Natchpai/LQRx-InterleavedBuck/documents/Images/GCM155R71H104KE02J-100nF50V.png

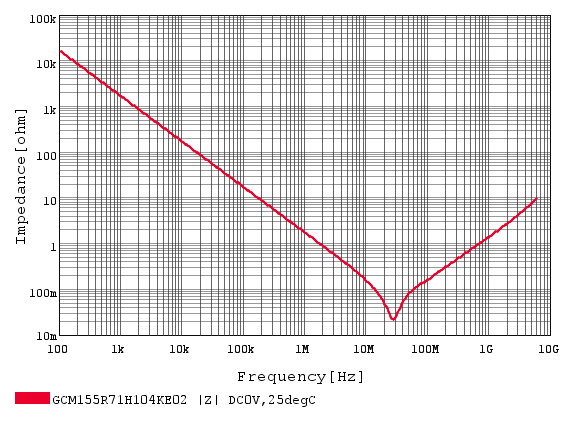
documents/Images/GCM155R71H104KE02J-100nF50V.png
