Natchpai/LQRx-InterleavedBuck/documents/Images/GRM21BZ71E106KE15L-10uF25V-Derating.png

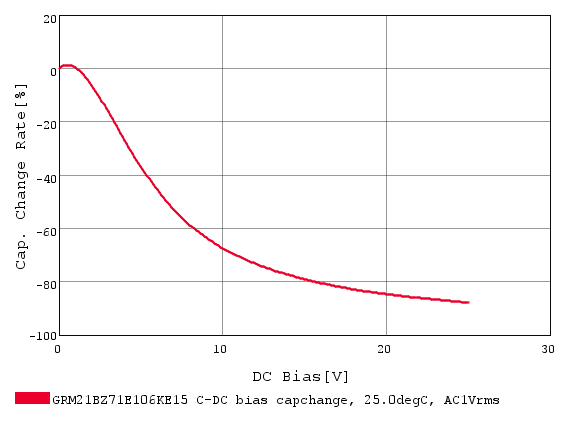
documents/Images/GRM21BZ71E106KE15L-10uF25V-Derating.png
