Natchpai/LQRx-InterleavedBuck/documents/Images/GRM21BZ71E475KE15L-4u7F25V-Derating.png

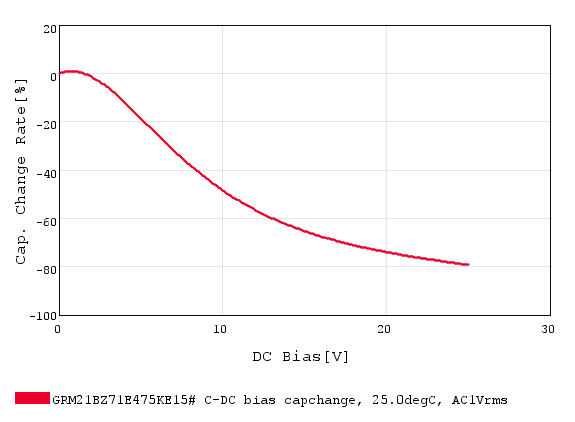
documents/Images/GRM21BZ71E475KE15L-4u7F25V-Derating.png
