Natchpai/LQRx-InterleavedBuck/documents/Images/GRM31CR71H475KA12L-4u7F50V_DC-Derate.png

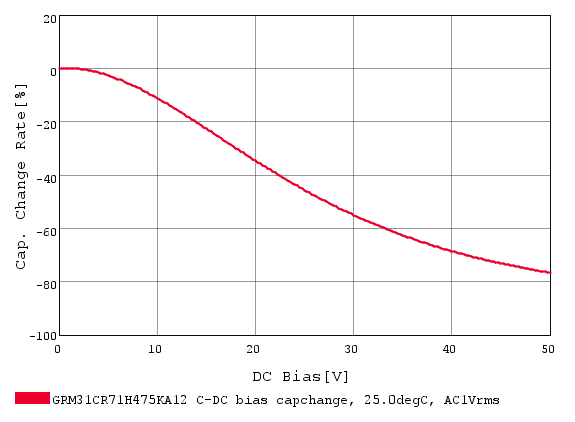
documents/Images/GRM31CR71H475KA12L-4u7F50V_DC-Derate.png
