Natchpai/LQRx-InterleavedBuck/documents/Images/GRM31CR71H475KA12L-4u7F50V_Z.png

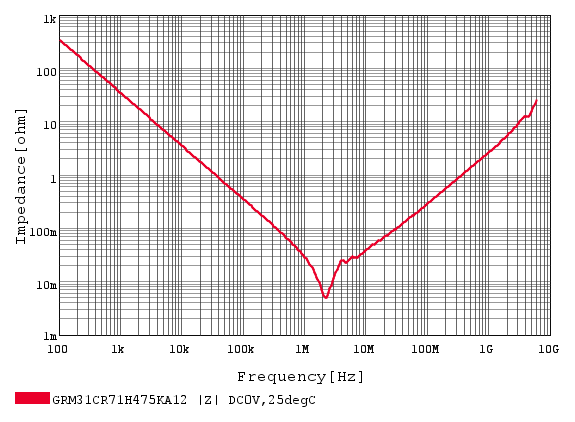
documents/Images/GRM31CR71H475KA12L-4u7F50V_Z.png
