Natchpai/LQRx-InterleavedBuck/documents/Images/GRM155R71E103KA01D.png

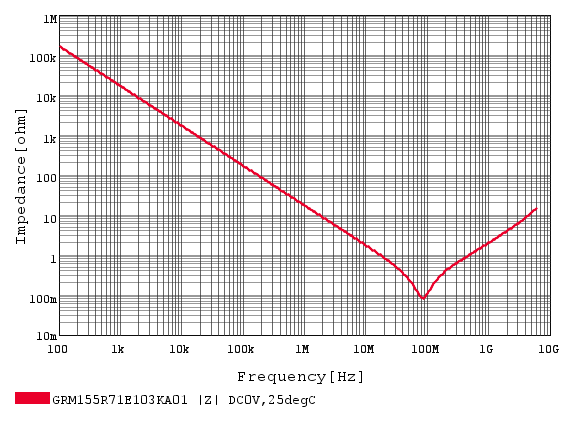
documents/Images/GRM155R71E103KA01D.png
