Natchpai/LQRx-InterleavedBuck/documents/Images/GRM1555C1E103JE01D.png

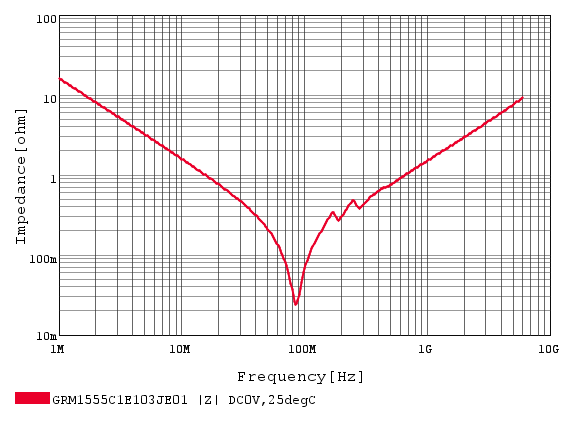
documents/Images/GRM1555C1E103JE01D.png
