Natchpai/LQRx-InterleavedBuck/documents/Images/GRT32ER71H475KE01L-4u7F50V_DC-Derate.png

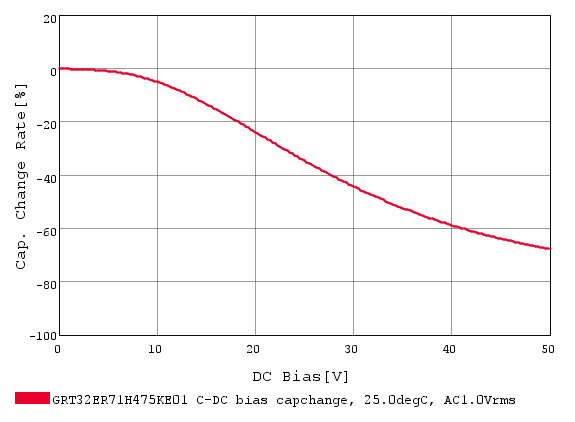
documents/Images/GRT32ER71H475KE01L-4u7F50V_DC-Derate.png
