Natchpai/LQRx-InterleavedBuck/documents/Images/Mini-Fit Jr 5569 4 Position Natural-nonBg.png

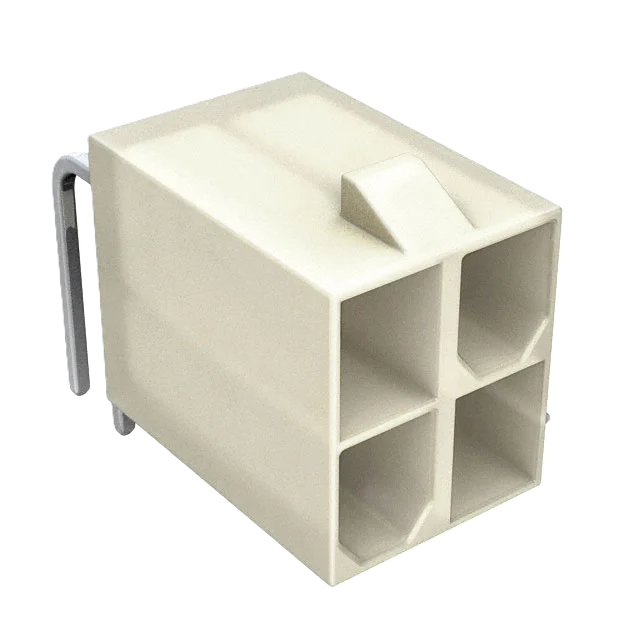
documents/Images/Mini-Fit Jr 5569 4 Position Natural-nonBg.png
