Natchpai/LQRx-InterleavedBuck/documents/Images/Render-Board/2Phase_SynchBuck_Bottomview_v1-1(Large).png

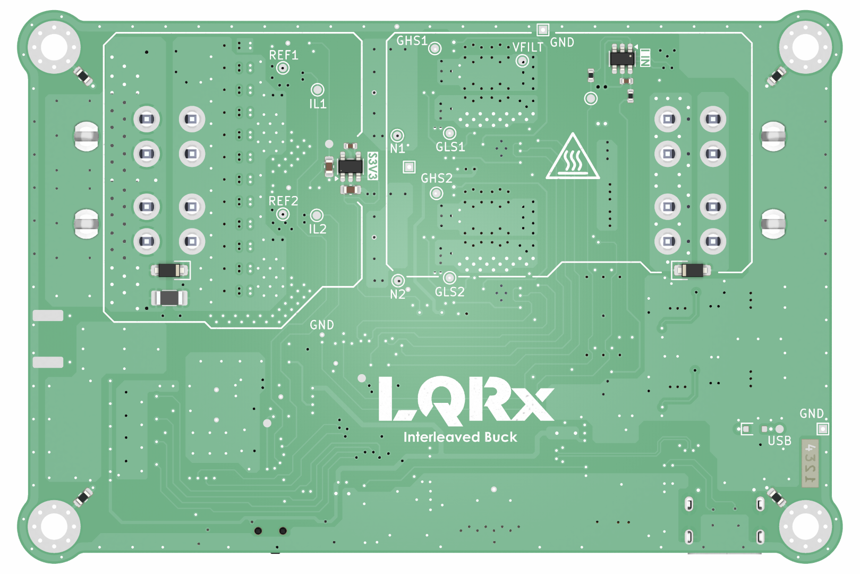
documents/Images/Render-Board/2Phase_SynchBuck_Bottomview_v1-1(Large).png
