Natchpai/LQRx-InterleavedBuck/documents/Images/Resistor_E96.png

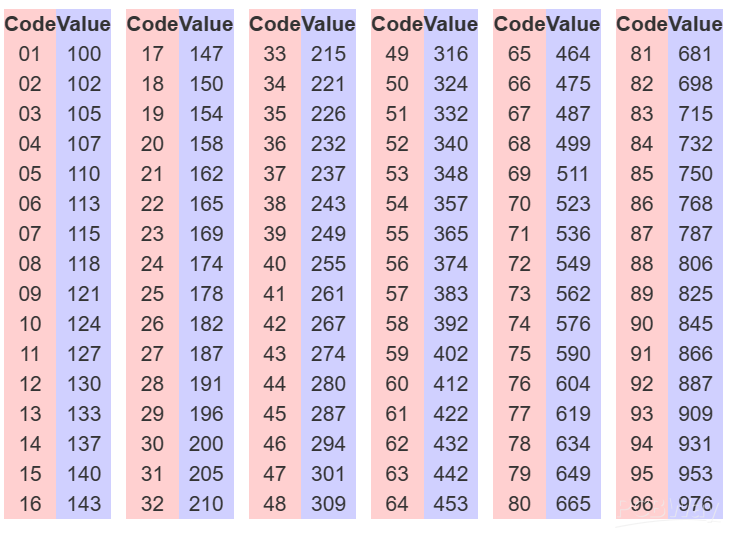
documents/Images/Resistor_E96.png
