Natchpai/LQRx-InterleavedBuck/documents/Manufacturing/Assembly/2Phase_SynchBuck-v1.1-24-08-2026__Assembly.pdf

C606 L102

# LD301 R107

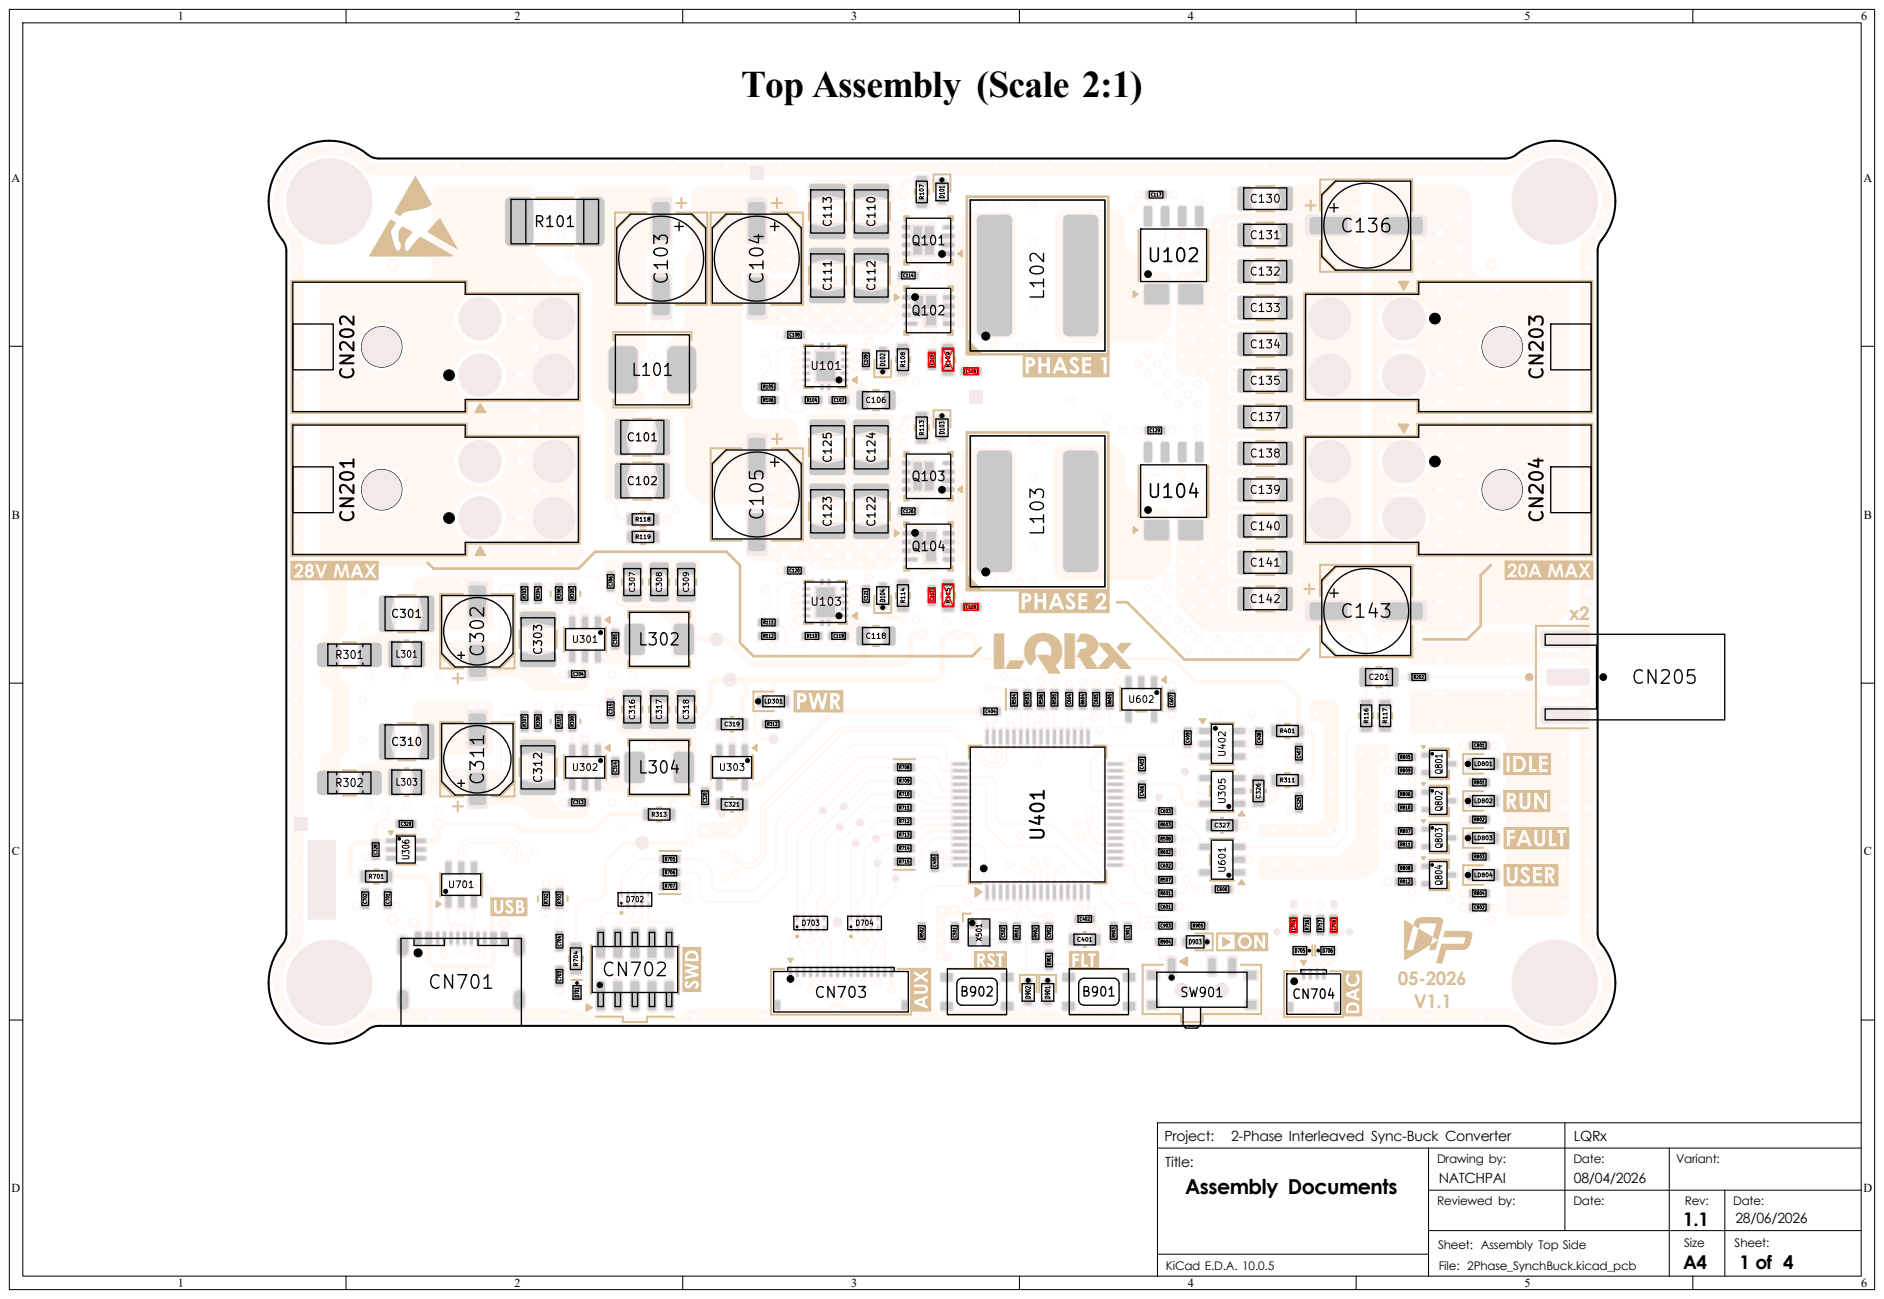
[picture p21: page 1]

Sheet: 2-Phase Interleaved Sync-Buck Converter

## GND VFILT

## GHS1

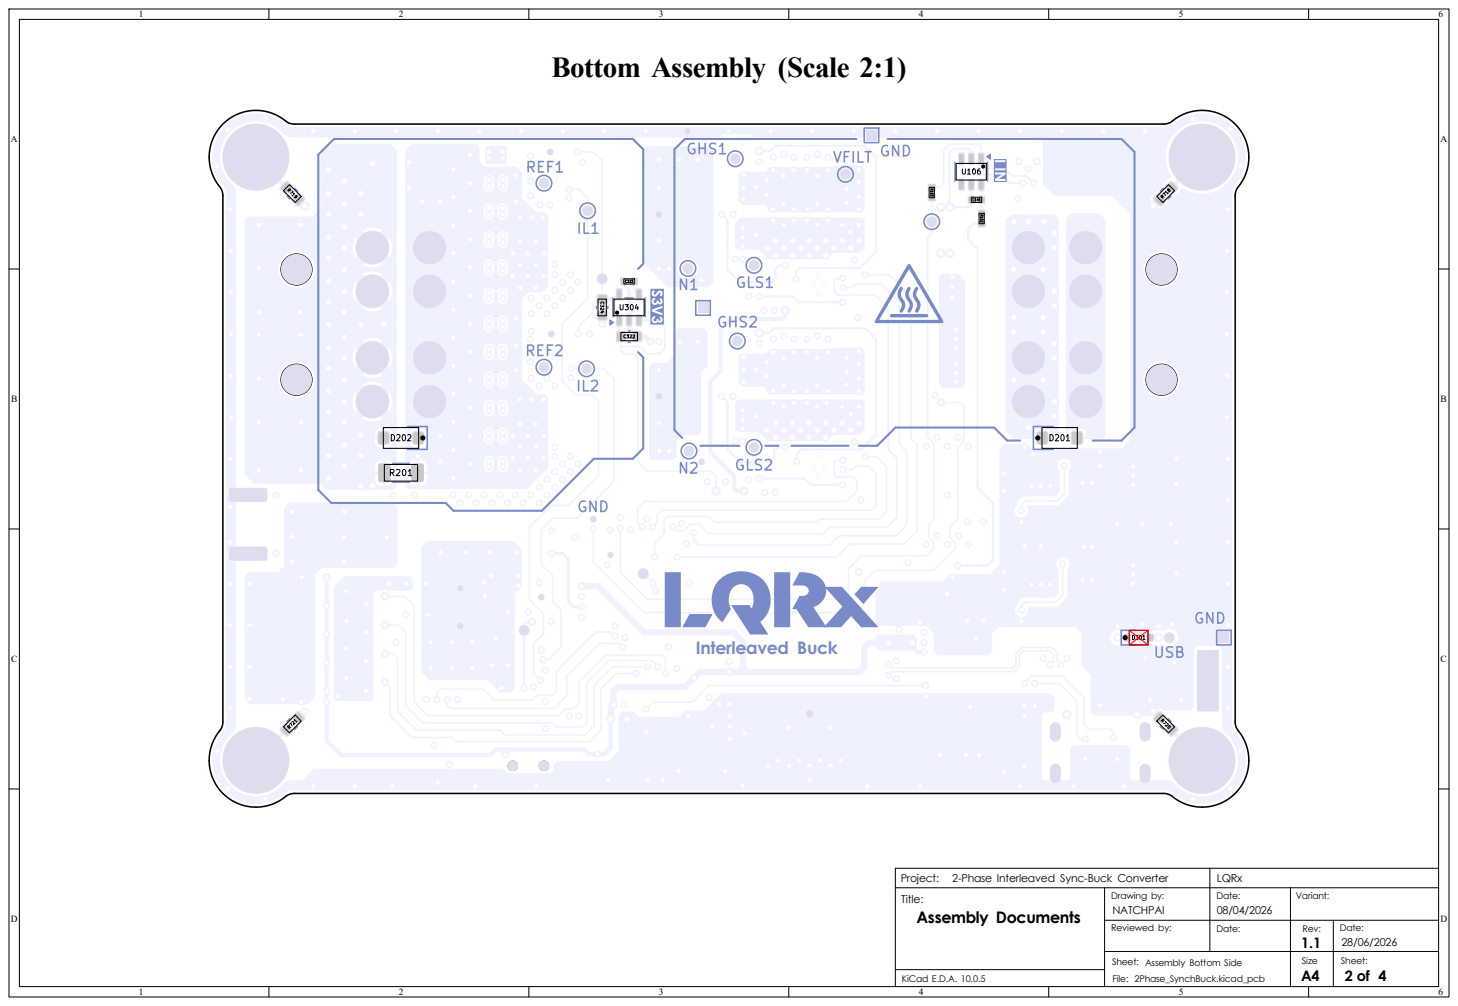
[picture p22: page 2]

Sheet: 2-Phase Interleaved Sync-Buck Converter

TP114

# DAC1 DAC2 Top Testpoint (Scale 2:1)

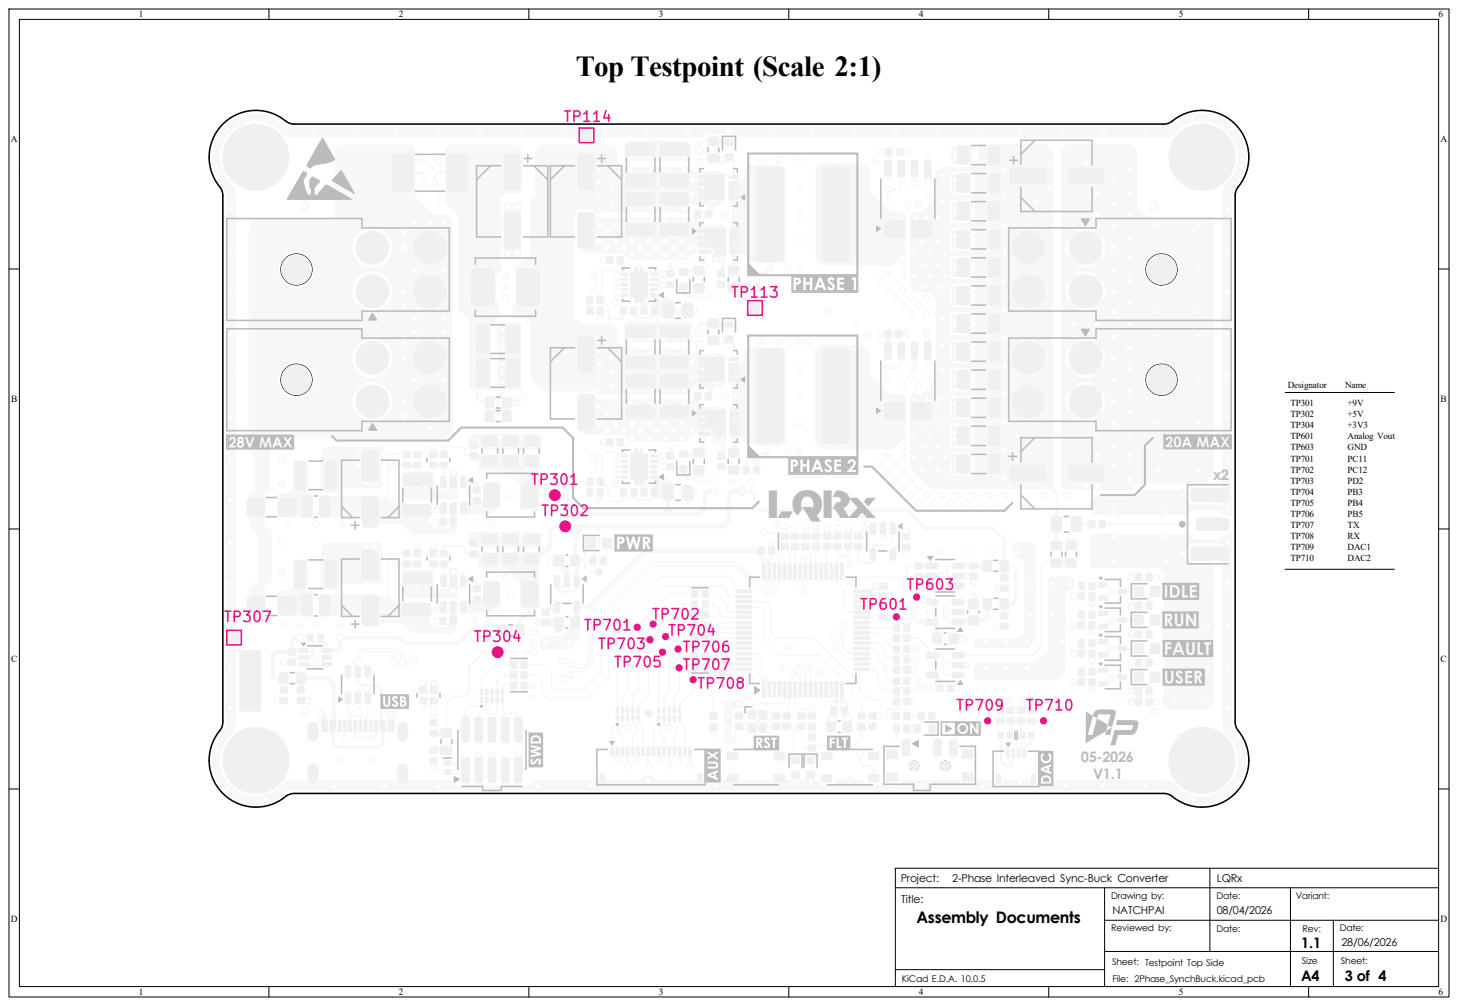
[picture p23: page 3]

Sheet: 2-Phase Interleaved Sync-Buck Converter

## GND VFILT

## GHS1

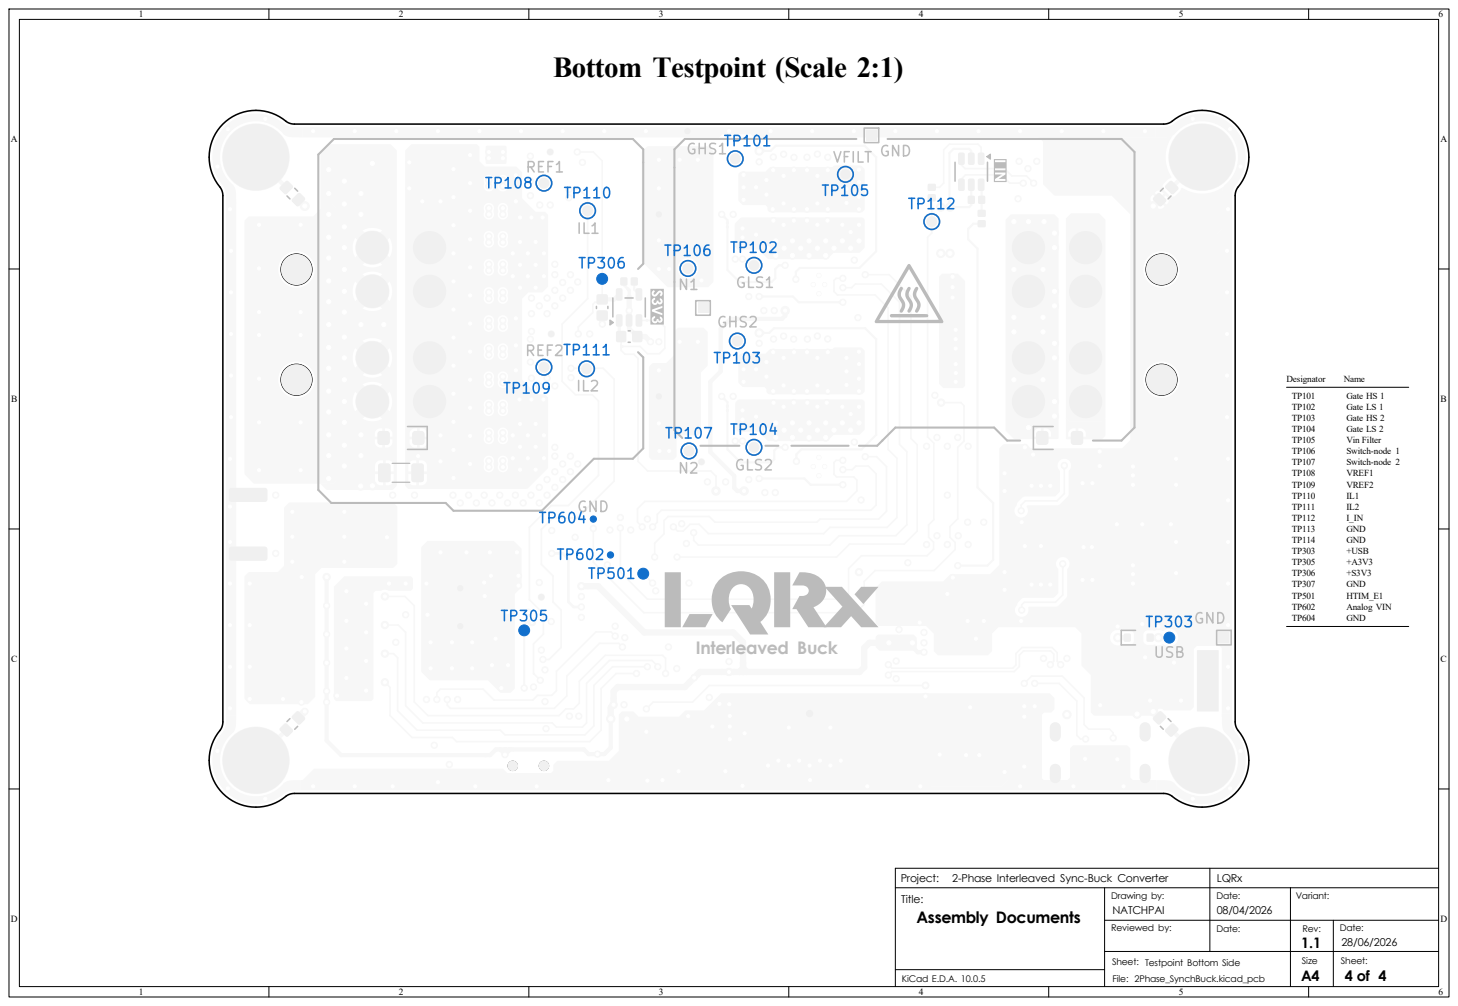
[picture p24: page 4]

Gate HS 1 Gate LS 1 Gate HS 2 Gate LS 2 Vin Filter Switch-node 1 Switch-node 2 VREF1 VREF2

Sheet: 2-Phase Interleaved Sync-Buck Converter
