Natchpai/LQRx-InterleavedBuck/documents/Manufacturing/Fabrication/2Phase_SynchBuck__FabricationDoc-v1.1.pdf

# Board Specifications

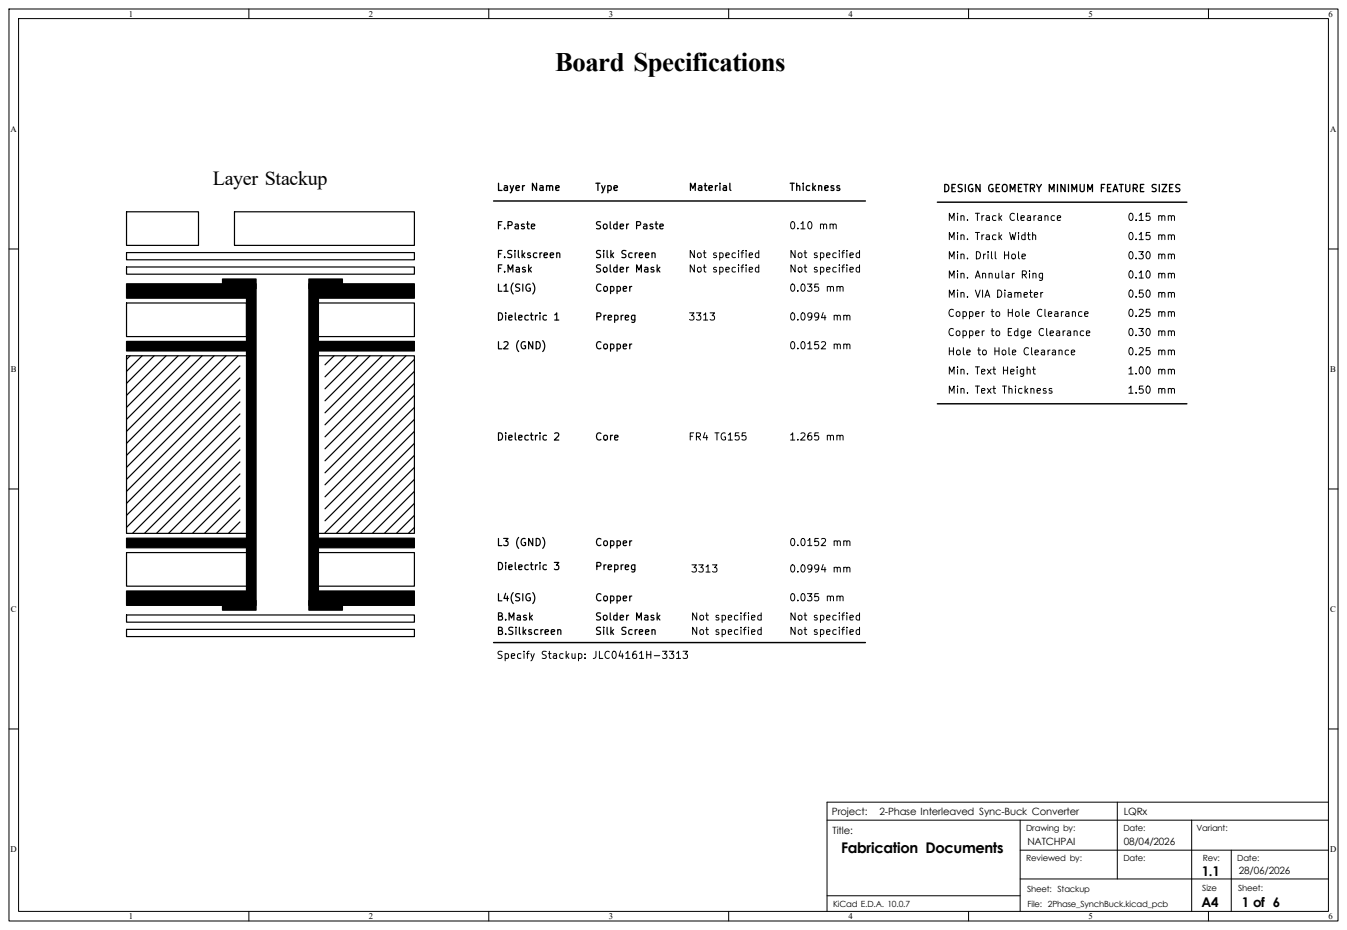
[picture p25: page 1]
Rev: 1.1; Stackup; Title:; Variant: Project:; Fabrication Documents; Size; Sheet: A4; LQRx Date: Date: KiCad E.D.A. 10.0.7; File: 2Phase_SynchBuck.kicad_pcb; Date: Specify Stackup: JLC04161H-3313; Not specified Not specified; F.Paste; F.Silkscreen F.Mask; L1(SIG); Dielectric 1; L2 (GND); Dielectric 2; L3 (GND); Dielectric 3; L4(SIG); B.Mask B.Silkscreen; Solder Paste; Silk Screen Solder Mask; Copper; Prepreg; Core; Solder Mask Silk Screen; Layer Name; Type; Material; Thickness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

Min. Track Clearance
Min. Track Width
Min. Drill Hole
Min. Annular Ring
Min. VIA Diameter
Copper to Hole Clearance
Copper to Edge Clearance
Hole to Hole Clearance
Min. Text Height
Min. Text Thickness

Sheet: 2-Phase Interleaved Sync-Buck Converter

Drawing by:
NATCHPAI Reviewed by:

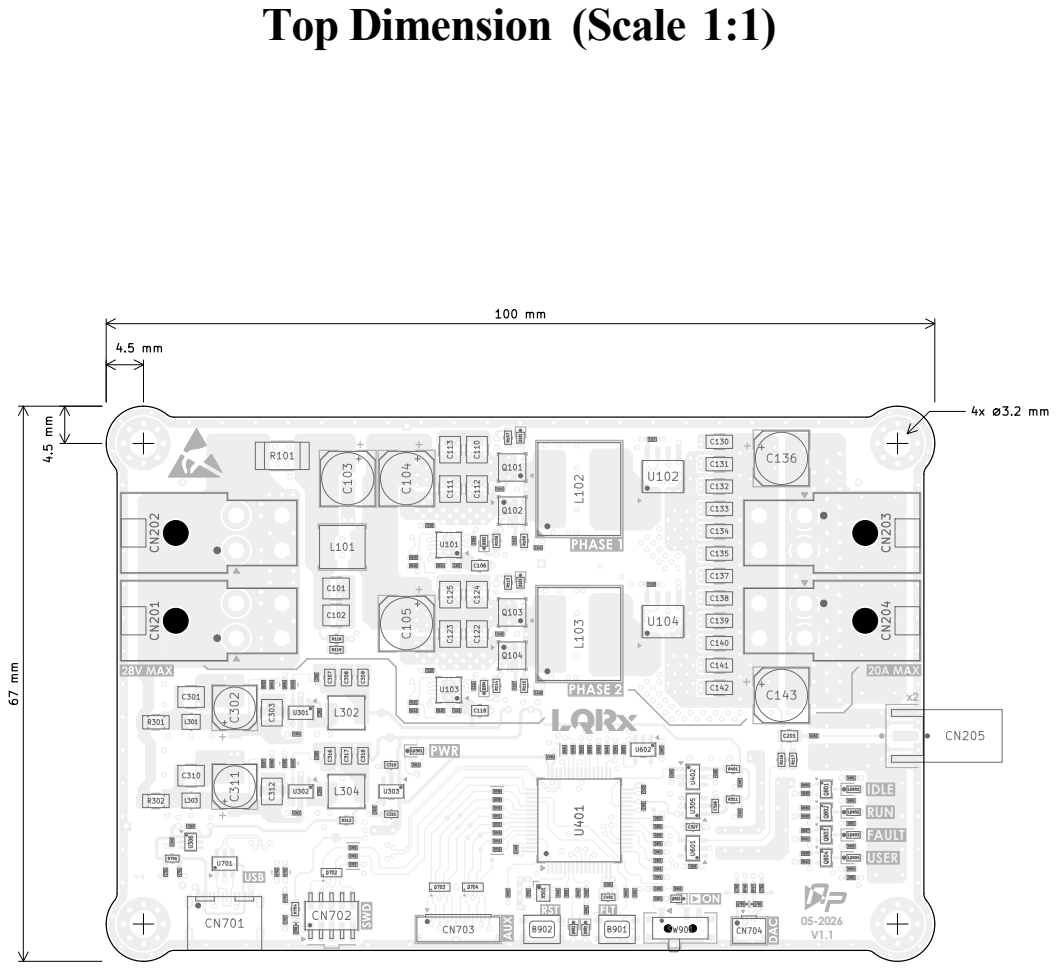
[picture p26: page 2]

Sheet: 2-Phase Interleaved Sync-Buck Converter

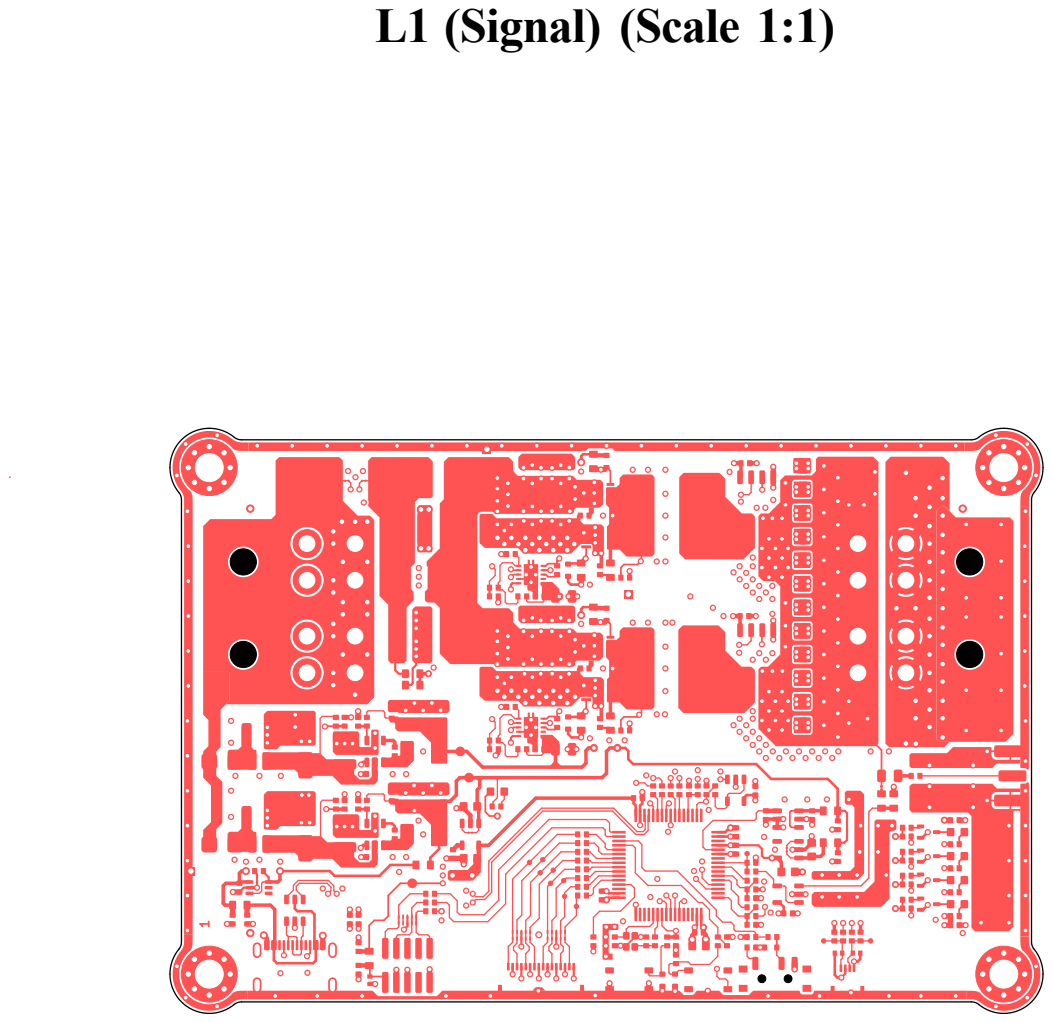
[picture p27: page 3]
Rev: 1.1; Fabri L1; Title:; Variant: Project:; Fabrication Documents; LQRx Date: Date: KiCad E.D.A. 10.0.7; File: 2Phase_SynchBuck.kicad_pcb; Date: L1 (Signal) (Scale 1:1)

Sheet: 2-Phase Interleaved Sync-Buck Converter

Drawing by:
NATCHPAI Reviewed by:

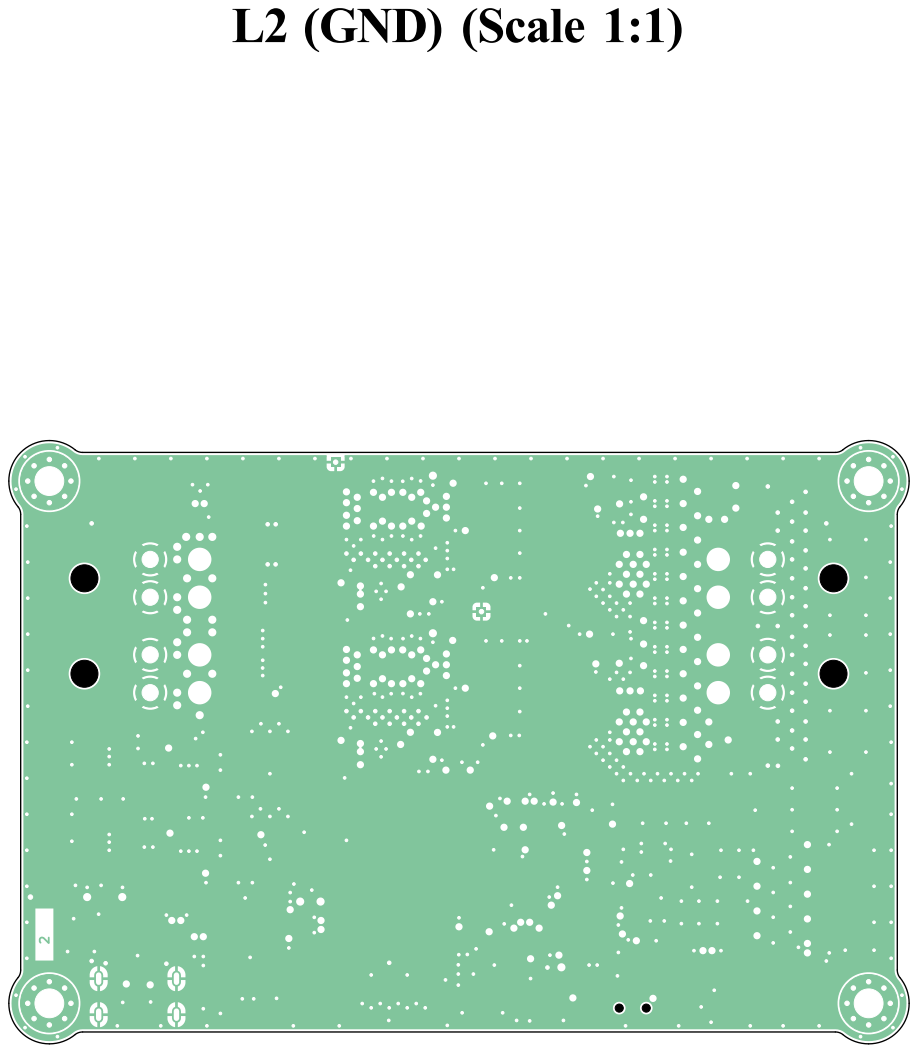
[picture p28: page 4]
Rev: 1.1; Title:; Variant: Project:; Fabrication Documents; LQRx Date: Date: KiCad E.D.A. 10.0.7; File: 2Phase_SynchBuck.kicad_pcb; Date: L2 (GND) (Scale 1:1)

Sheet: 2-Phase Interleaved Sync-Buck Converter

Drawing by:
NATCHPAI Reviewed by:

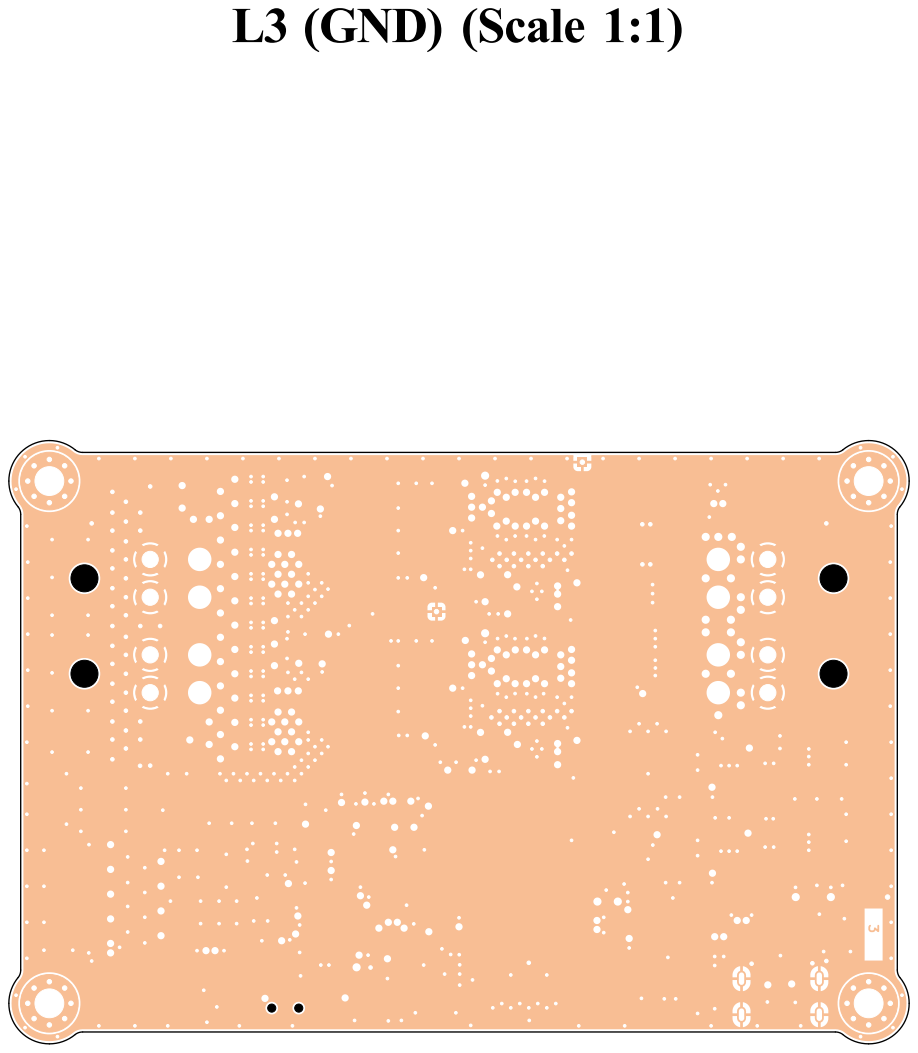
[picture p29: page 5]
Rev: 1.1; Title:; Variant: Project:; Fabrication Documents; LQRx Date: Date: KiCad E.D.A. 10.0.7; File: 2Phase_SynchBuck.kicad_pcb; Date: L3 (GND) (Scale 1:1)

Sheet: 2-Phase Interleaved Sync-Buck Converter

Drawing by:
NATCHPAI Reviewed by:

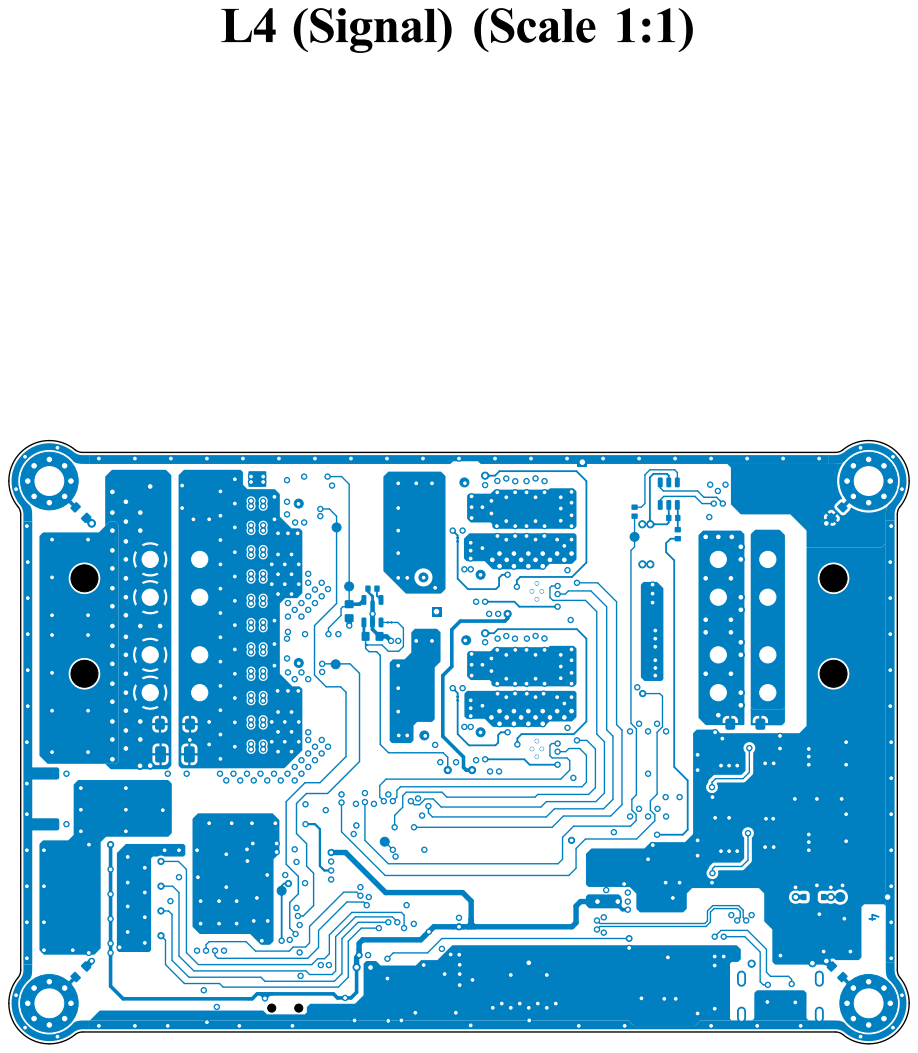
[picture p30: page 6]
Rev: 1.1; Title:; Variant: Project:; Fabrication Documents; LQRx Date: Date: KiCad E.D.A. 10.0.7; File: 2Phase_SynchBuck.kicad_pcb; Date: L4 (Signal) (Scale 1:1)

Sheet: 2-Phase Interleaved Sync-Buck Converter

Drawing by:
NATCHPAI Reviewed by:
