Natchpai/LQRx-InterleavedBuck/2Phase_SynchBuck.kicad_pcb

## KiCad design 2Phase_SynchBuck.kicad_pcb (2026-10-17)

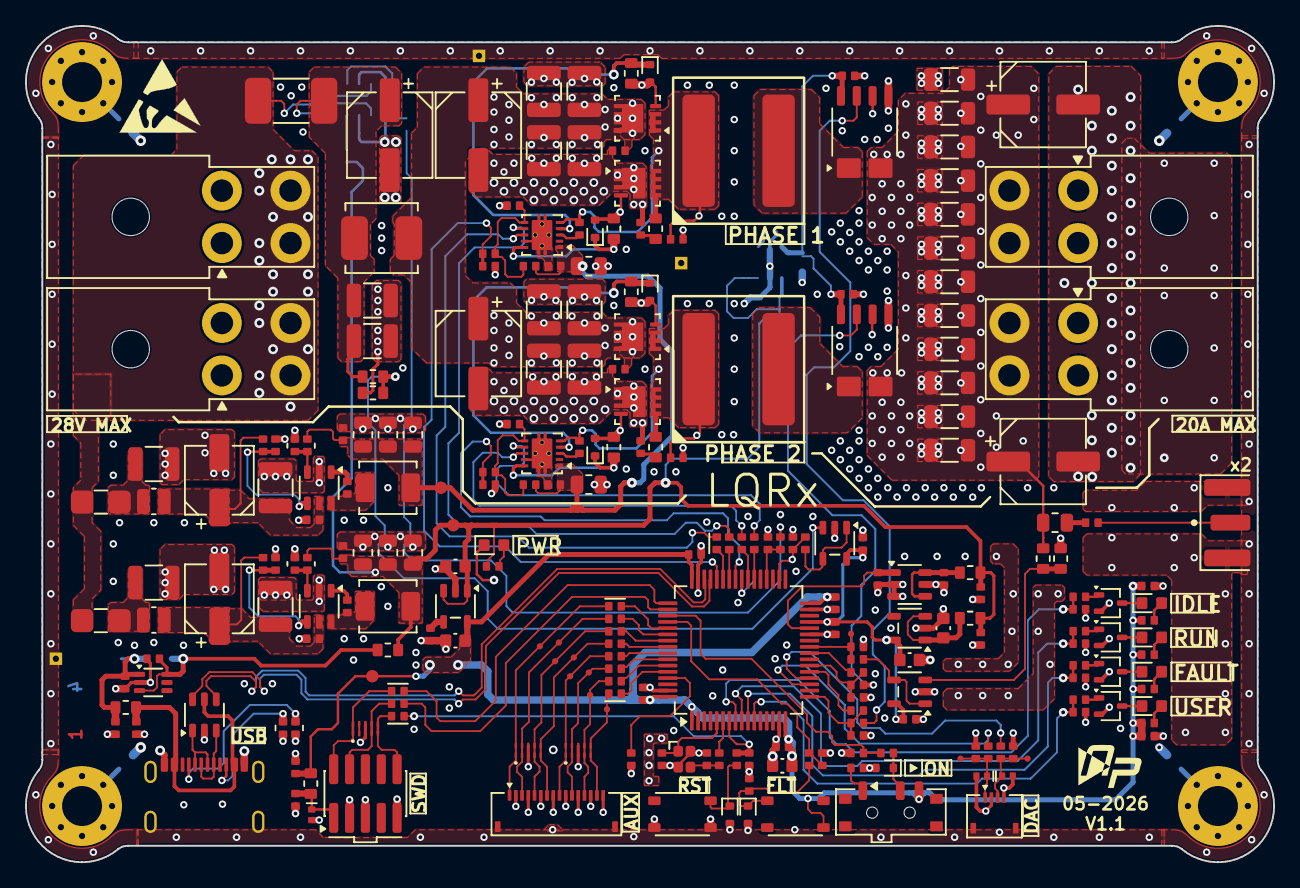
[picture p31: board 2Phase_SynchBuck.kicad_pcb from above]

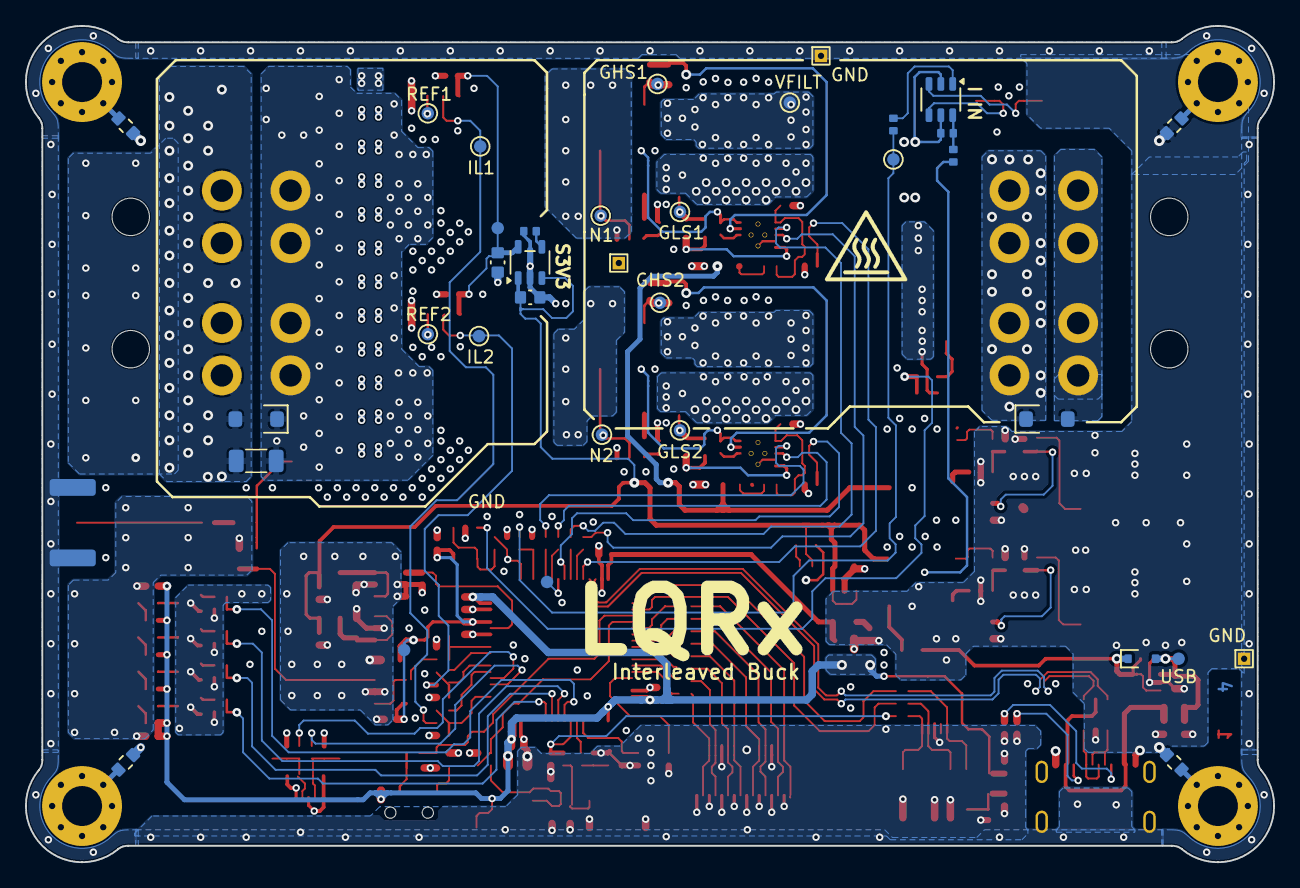
[picture p32: board 2Phase_SynchBuck.kicad_pcb from below]

Board: 4 copper layers, 100.0 x 67.0 mm, 305 parts (41 on the bottom side), 152 nets.

Parts:
B901, B902: SW_Tactile_PTS815SJM250
C101, C102, C110, C111, C112, C113, C122, C123, C124, C125, C301, C303, C310, C312: 4u7; C_1210_nomDensity
C103, C104, C105: 47u; CP_Elec_6.3x5.5_WCAP-ASLI
C106, C118, C307, C308, C309, C316, C317, C318: 4u7; C_0805_nomDensity
C107, C108, C109, C114, C117, C119, C120, C121, C126, C129, C145, C304, C305, C306, C313, C314, C315, C320, C323, C325, C328, C329, C402, C403, C404, C405, C406, C407, C408, C409, C606, C607, C701, C702, C703, C704, C705, C706, C801, C802, C901, C902, C903: 100n; C_0402_nomDensity
C115, C127: N/A; C_0402_nomDensity
C116, C128: 100p; C_0402_nomDensity
C130, C131, C132, C133, C134, C135, C137, C138, C139, C140, C141, C142: 4u7; C_1206_nomDesity
C136, C143: 47u; CP_Elec_6.3x6_OS-CON-SVPK
C201: 1u; C_0805_nomDensity
C302, C311: 22u; CP_Elec_5x5.5_WCAP-ASLI
C319, C321, C322, C324, C326, C327, C401: 2u2; C_0603_nomDensity
C501, C502: 6p8; C_0402_nomDensity
C601, C602, C603, C604, C605: 1n; C_0402_nomDensity
CN201, CN202, CN203, CN204: 04A2; Molex_Mini-Fit_Jr_5569-04A2_2x02_P4.20mm_Horizontal
CN205: SMA-J-P-H-ST-EM1; SMA_Samtec_SMA-J-P-H-ST-EM1_EdgeMount
CN701: USB4215-03-A; USB_C_Receptacle_GCT_USB4215-03-A_16P_TopMnt_Horizontal
CN702: Conn_JTAG_STDC10; BD_2x05_P1.27mm_Vertical_SMD
CN703: FFC2B28-16-G; GCT_FFC2B28-16_P0.5_FFC-16
CN704: FFC2B28-04-G; GCT_FFC2B28-04_P0.5_FFC-4
D101, D102, D103, D104: BAT54XV2T5G; D_SOD-523
D201, D202: SMF4L28A; D_SOD-123FL
D301: BAT60JFILM; D_SOD-323
D701, D705, D706: SP3031-01ETG; D_SOD-882
D702, D703, D704: PUSB3FR4Z; SOT1176-2-_1x2.5mm_P0.5mm
D901, D902, D903: ESD5Z3V3; D_SOD-523
G101: SYM_Hot_Large; hot_surface
G102: SYM_ESD_Large; ESD-Logo_6.6x6mm_SilkScreen
G103: np_logo_5mm
H701, H702, H703, H704: MountingHole_Pad; MountingHole_3.2mm_M3_Pad_Via
L101: 1u; AMPLH5030S
L102, L103: 10u; 744393665100
L301, L303: 2u2; L_0806_BDCD00201610
L302, L304: 22u; AMDLA4020S
LD301, LD802: Green; LED_0603_1608Metric
LD801, LD804: Orange; LED_0603_1608Metric
LD803: Red; LED_0603_1608Metric
NT101: IN_SENSE+; NetTie-2_SMD_Pad0.15mm
NT102: IN_SENSE-; NetTie-2_SMD_Pad0.15mm
NT103, NT104: sw node; NetTie-2_SMD_Pad0.2mm
NT105: Vsense; NetTie-2_SMD_Pad0.2mm
NT303, NT304, NT305: EN; NetTie-2_SMD_Pad0.15mm
Q101, Q103: BSZ018N04LS6; PG-TSDSON-8-26
Q102, Q104: IQE013N04LM6; PG-TSON-8-4
Q801, Q802, Q803, Q804: GS2N7002KW; SOT-323_SC-70
R101: 5m; R_PA2512_R005-R006_YAGEO
R102, R103, R501, R503, R504, R505, R506, R705, R706, R707, R708, R709, R710, R711, R712, R713, R714, R715, R716, R717: 22R; R_0402_nomDensity
R104, R110, R304, R306, R308, R310: 21k5; R_0402_nomDensity
R105, R111, R604, R805, R806, R807, R808, R902: 100R; R_0402_nomDensity
R106, R112, R809, R810, R811, R812: 100k; R_0402_nomDensity
R107, R108, R113, R114: 2R21; R_0603_nomDensity
R109, R115: N/A; R_0603_nomDensity
R116, R118: 90k9; R_0603_nomDensity
R117, R119: 10k; R_0603_nomDensity
R201: 1k; R_1206_YEGEO
R202, R507, R508, R601, R602, R603, R605: 49R9; R_0402_nomDensity
R301, R302: 20m; R_PA1206_R004-R020_YAGEO
R303: 162k; R_0402_nomDensity
R305: 221k; R_0402_nomDensity
R307: 110k; R_0402_nomDensity
R309: 118k; R_0402_nomDensity
R311, R313, R401, R701, R704, R718, R719, R720, R721: 0R; R_0603_nomDensity
R312, R702, R703: 5k11; R_0402_nomDensity
R502, R802, R803, R903, R905: 1k; R_0402_nomDensity
R801, R804: 499; R_0402_nomDensity
R901, R904: 10k; R_0402_nomDensity
SW901: SW_SPDT; SW_SPDT_PCM12
TP101: Gate HS 1; TestPoint_Pad_D1.0mm_Bottom
TP102: Gate LS 1; TestPoint_Pad_D1.0mm_Bottom
TP103: Gate HS 2; TestPoint_Pad_D1.0mm_Bottom
TP104: Gate LS 2; TestPoint_Pad_D1.0mm_Bottom
TP105: Vin Filter; TestPoint_Pad_D1.0mm_Bottom
TP106: Switch-node 1; TestPoint_Pad_D1.0mm_Bottom
TP107: Switch-node 2; TestPoint_Pad_D1.0mm_Bottom
TP108: VREF1; TestPoint_Pad_D1.0mm_Bottom
TP109: VREF2; TestPoint_Pad_D1.0mm_Bottom
TP110: IL1; TestPoint_Pad_D1.0mm_Bottom
TP111: IL2; TestPoint_Pad_D1.0mm_Bottom
TP112: I_IN; TestPoint_Pad_D1.0mm_Bottom
TP113, TP114, TP307: GND; TestPoint_THTPad_1.0x1.0mm_Drill0.5mm
TP301: +9V; TestPoint_NoSlik_D1.0mm_Top
TP302: +5V; TestPoint_NoSlik_D1.0mm_Top
TP303: +USB; TestPoint_NoSlik_D1.0mm_Bottom
TP304: +3V3; TestPoint_NoSlik_D1.0mm_Top
TP305: +A3V3; TestPoint_NoSlik_D1.0mm_Bottom
TP306: +S3V3; TestPoint_NoSlik_D1.0mm_Bottom
TP501: HTIM_E1; TestPoint_NoSlik_D1.0mm_Bottom
TP601: Analog Vout; TestPoint_NoSlik_D0.5mm_Top
TP602: Analog VIN; TestPoint_NoSlik_D0.5mm_Bottom
TP603: GND; TestPoint_NoSlik_D0.5mm_Top
TP604: GND; TestPoint_NoSlik_D0.5mm_Bottom
TP701: PC11; TestPoint_NoSlik_D0.5mm_Top
TP702: PC12; TestPoint_NoSlik_D0.5mm_Top
TP703: PD2; TestPoint_NoSlik_D0.5mm_Top
TP704: PB3; TestPoint_NoSlik_D0.5mm_Top
TP705: PB4; TestPoint_NoSlik_D0.5mm_Top
TP706: PB5; TestPoint_NoSlik_D0.5mm_Top
TP707: TX; TestPoint_NoSlik_D0.5mm_Top
TP708: RX; TestPoint_NoSlik_D0.5mm_Top
TP709: DAC1; TestPoint_NoSlik_D0.5mm_Top
TP710: DAC2; TestPoint_NoSlik_D0.5mm_Top
U101, U103: UCC27282DRC; 10-VSON(3x3)-DRC
U102, U104: ACS37030LLZATR-040B3; ACS37030LLZA
U106: INA187A1IDBVR; SOT-23-6
U301, U302: LMR54410DBVR; SOT-23-6
U303, U304: SPX3819M5-L-3-3/TR; SOT-23-5
U305: LDLN025M33R; SOT-23-5
U306: LM66100DCK; DCK0006A_TI
U401: STM32G474RET6; LQFP-64_10x10mm_P0.5mm
U402: MCP1501T-30E; SOT-23-6
U601, U602: TLV9061SIDBVR; SOT-23-5
U701: USBLC6-2SC6; SOT-23-6
X501: ABM11W-24MHz-8; ABM11W_2.0x1.6mm

Connections:
+3V3: B901.1, B901.2, C321.1, C401.1, C402.1, C403.1, C404.1, C405.1, C704.1, C801.1, C802.1, R704.2, R801.1, R802.1, R803.1, R804.1, SW901.3 (C), TP304.1 (1_1), U303.5 (OUT), U401.1 (VBAT), U401.16 (VDD), U401.32 (VDD), U401.48 (VDD), U401.64 (VDD)
+5V: C315.1, C316.1, C317.1, C318.1, C319.1, C322.1, C325.1, C407.1, L304.2, NT303.1, NT304.1, R102.1, R309.1, R311.1, R312.1, R313.2, R401.1, TP302.1 (1_1), U303.1 (IN), U304.1 (IN)
+9V: C106.1, C107.1, C118.1, C119.1, C306.1, C307.1, C308.1, C309.1, L302.2, R104.2, R110.1, R305.1, TP301.1 (1_1), U101.1 (VDD), U103.1 (VDD)
+A3V3: C327.1, C406.1, C606.1, C607.2, TP305.1 (1_1), U305.5 (OUT), U401.29 (VDDA), U601.5 (V+), U602.5 (V+)
+S3V3: C117.1, C129.1, C324.1, TP306.1 (1_1), U102.6 (VDD), U104.6 (VDD), U304.5 (OUT)
+VIN: C101.1, C102.1, C103.1, L101.1, NT102.2, R101.2, R118.1
+VUSB: C328.1, C702.1, D301.2 (A), R701.2, TP303.1 (1_1), U306.1 (VIN)
/Top/Analog Front-End/OP_FB_VIN: R605.1, U602.1, U602.4 (-)
/Top/Analog Front-End/OP_FB_VO: R603.1, U601.1, U601.4 (-)
/Top/Interface Interconnects/AUX1_TR1: CN703.1, D703.1 (K), D703.10, R708.1, TP701.1 (1_1)
/Top/Interface Interconnects/AUX1_TR2: CN703.3, D703.2 (K), D703.9, R709.1, TP702.1 (1_1)
/Top/Interface Interconnects/AUX1_TR3: CN703.5, D703.4 (K), D703.7, R710.1, TP703.1 (1_1)
/Top/Interface Interconnects/AUX1_TR4: CN703.7, D703.5 (K), D703.6, R711.1, TP704.1 (1_1)
/Top/Interface Interconnects/AUX1_TR5: CN703.9, D704.1 (K), D704.10, R712.1, TP705.1 (1_1)
/Top/Interface Interconnects/AUX1_TR6: CN703.11, D704.2 (K), D704.9, R713.1, TP706.1 (1_1)
/Top/Interface Interconnects/CC1: CN701.A5 (CC1), R703.1
/Top/Interface Interconnects/CC2: CN701.B5 (CC2), R702.1
/Top/Interface Interconnects/DAC1_TR: C705.1, CN704.1, D705.1, R716.1, TP709.1 (1_1)
/Top/Interface Interconnects/DAC2_TR: C706.1, CN704.3, D706.1, R717.1, TP710.1 (1_1)
/Top/Interface Interconnects/MT1: H701.1 (1_1), R718.1
/Top/Interface Interconnects/MT2: H702.1 (1_1), R719.1
/Top/Interface Interconnects/MT3: H703.1 (1_1), R720.1
/Top/Interface Interconnects/MT4: H704.1 (1_1), R721.1
/Top/Interface Interconnects/NRST_TR: CN702.10 (NRESET), D702.5 (K), D702.6, R707.1
/Top/Interface Interconnects/RX_TR: CN703.15, D704.5 (K), D704.6, R715.1, TP708.1 (1_1)
/Top/Interface Interconnects/SWCLK_TR: CN702.4 (SWDCLK/TCK), D702.4 (K), D702.7, R706.1
/Top/Interface Interconnects/SWDIO_TR: CN702.2 (SWDIO/TMS), D702.1 (K), D702.10, R705.1
/Top/Interface Interconnects/TX_TR: CN703.13, D704.4 (K), D704.7, R714.1, TP707.1 (1_1)
/Top/Interface Interconnects/USB_IN+: CN701.A6 (D+), CN701.B6 (D+), U701.3 (I/O2)
/Top/Interface Interconnects/USB_IN-: CN701.A7 (D-), CN701.B7 (D-), U701.1 (I/O1)
/Top/Interface Interconnects/VTREF: C703.1, CN702.1 (VTRef), D701.1, R704.1
/Top/Interface Interconnects/VUSB_IN: C701.1, CN701.A4 (VBUS), CN701.A9 (VBUS), CN701.B4 (VBUS), CN701.B9 (VBUS), R701.1, U701.5 (VBUS)
/Top/MCU IOs/ADC1_I_CH1: C601.1, R507.1, R601.2, U401.17 (PA3)
/Top/MCU IOs/ADC2_I_CH2: C602.1, R508.1, R602.2, U401.22 (PC4)
/Top/MCU IOs/ADC3_VOUT: C603.1, R603.2, TP601.1 (1_1), U401.25 (PB1)
/Top/MCU IOs/ADC4_I_IN: C604.1, R604.2, U401.36 (PB14)
/Top/MCU IOs/ADC4_VIN: C605.1, R605.2, TP602.1 (1_1), U401.34 (PB12)
/Top/MCU IOs/BOOT0: R502.1, U401.61 (PB8)
/Top/MCU IOs/BT1_USER: C901.1, R903.2, U401.52 (PC10)
/Top/MCU IOs/COMP2_I_CH1: R507.2, U401.21 (PA7)
/Top/MCU IOs/COMP4_I_CH2: R508.2, U401.24 (PB0)
/Top/MCU IOs/DAC1_OUT2: R716.2, U401.19 (PA5)
/Top/MCU IOs/DAC2_OUT1: R717.2, U401.20 (PA6)
/Top/MCU IOs/EN_CH1: R105.1, R106.1, U401.44 (PA10)
/Top/MCU IOs/EN_CH2: R111.1, R112.1, U401.41 (PC9)
/Top/MCU IOs/HRTIM_CHE1: TP501.1 (1_1), U401.40 (PC8)
/Top/MCU IOs/LED_FAULT: R807.1, R811.1, U401.10 (PC2)
/Top/MCU IOs/LED_IDLE: R805.1, R809.1, U401.8 (PC0)
/Top/MCU IOs/LED_RUN: R806.1, R810.1, U401.9 (PC1)
/Top/MCU IOs/LED_USER1: R808.1, R812.1, U401.11 (PC3)
/Top/MCU IOs/NRST: C902.1, R707.2, R902.1, U401.7 (PG10)
/Top/MCU IOs/OSC_IN: C501.1, U401.5 (PF0), X501.1
/Top/MCU IOs/OSC_OUT: R501.1, U401.6 (PF1)
/Top/MCU IOs/PB3: R711.2, U401.56 (PB3)
/Top/MCU IOs/PB4: R712.2, U401.57 (PB4)
/Top/MCU IOs/PB5: R713.2, U401.58 (PB5)
/Top/MCU IOs/PC11: R708.2, U401.53 (PC11)
/Top/MCU IOs/PC12: R709.2, U401.54 (PC12)
/Top/MCU IOs/PD2: R710.2, U401.55 (PD2)
/Top/MCU IOs/PWM_HS_1_TR: R503.2, U401.42 (PA8)
/Top/MCU IOs/PWM_HS_2_TR: R505.2, U401.38 (PC6)
/Top/MCU IOs/PWM_HS_CH1: R503.1, U101.7 (HI)
/Top/MCU IOs/PWM_HS_CH2: R505.1, U103.7 (HI)
/Top/MCU IOs/PWM_LS_1_TR: R504.2, U401.43 (PA9)
/Top/MCU IOs/PWM_LS_2_TR: R506.2, U401.39 (PC7)
/Top/MCU IOs/PWM_LS_CH1: R504.1, U101.8 (LI)
/Top/MCU IOs/PWM_LS_CH2: R506.1, U103.8 (LI)
/Top/MCU IOs/SW1_USER: C903.1, R905.2, U401.51 (PA15)
/Top/MCU IOs/SWCLK: R706.2, U401.50 (PA14)
/Top/MCU IOs/SWDIO: R705.2, U401.49 (PA13)
/Top/MCU IOs/USART1_RX: R715.2, U401.60 (PB7)
/Top/MCU IOs/USART1_TX: R714.2, U401.59 (PB6)
/Top/MCU IOs/USB_D+: U401.46 (PA12), U701.4 (I/O2)
/Top/MCU IOs/USB_D-: U401.45 (PA11), U701.6 (I/O1)
/Top/MCU IOs/X_3: C502.1, R501.2, X501.3
/Top/MCU Power/+3VREF: C409.1, U401.28 (VREF+), U402.1 (OUT)
/Top/MCU Power/REF_IN: C408.1, R401.2, U402.4 (~SHDN), U402.6 (VDD)
/Top/Power Connectors/CP_C_R: C201.2, R202.2
/Top/Power Connectors/CP_R_SMA: CN205.1 (In), R202.1
/Top/Power Connectors/PWR_IN: CN201.3, CN201.4, CN202.3, CN202.4, D201.1, NT101.2, R101.1, R301.1, R302.1
/Top/Power Connectors/PWR_OUT: C130.1, C131.1, C132.1, C133.1, C134.1, C135.1, C136.1, C137.1, C138.1, C139.1, C140.1, C141.1, C142.1, C143.1, C201.1, CN203.3, CN203.4, CN204.3, CN204.4, D202.1, NT105.1, R201.1, U102.2 (IP-), U104.2 (IP-)
/Top/Power State/DRV_GATE_HS1: D101.2 (A), Q101.4, R107.2, TP101.1 (1_1)
/Top/Power State/DRV_GATE_HS2: D103.2 (A), Q103.4, R113.2, TP103.1 (1_1)
/Top/Power State/DRV_GATE_LS1: D102.2 (A), Q102.4, R108.2, TP102.1 (1_1)
/Top/Power State/DRV_GATE_LS2: D104.2 (A), Q104.4, R114.2, TP104.1 (1_1)
/Top/Power State/DRV_HB1: C109.1, U101.3 (HB)
/Top/Power State/DRV_HB2: C121.1, U103.3 (HB)
/Top/Power State/DRV_HO1: D101.1 (K), R107.1, U101.4 (HO)
/Top/Power State/DRV_HO2: D103.1 (K), R113.1, U103.4 (HO)
/Top/Power State/DRV_HS1: C109.2, NT103.1, U101.5 (HS)
/Top/Power State/DRV_HS2: C121.2, NT104.1, U103.5 (HS)
/Top/Power State/DRV_LO1: D102.1 (K), R108.1, U101.10 (LO)
/Top/Power State/DRV_LO2: D104.1 (K), R114.1, U103.10 (LO)
/Top/Power State/EN1: C108.1, R104.1, R105.2, U101.6 (EN)
/Top/Power State/EN2: C120.1, R110.2, R111.2, U103.6 (EN)
/Top/Power State/I_INSE_VS: C145.1, R102.2, U106.6 (Vs)
/Top/Power State/I_IN_N: NT102.1, U106.4 (IN-)
/Top/Power State/I_IN_P: NT101.1, U106.3 (IN+)
/Top/Power State/I_IN_TR: R103.1, U106.1 (OUT)
/Top/Power State/PWR_SENSE_I_IN1: L102.2, U102.1 (IP+)
/Top/Power State/PWR_SENSE_I_IN2: L103.2, U104.1 (IP+)
/Top/Power State/PWR_SWNode_P1: C116.1, L102.1, NT103.2, Q101.1, Q102.8, R109.1, TP106.1 (1_1)
/Top/Power State/PWR_SWNode_P2: C128.1, L103.1, NT104.2, Q103.1, Q104.8, R115.1, TP107.1 (1_1)
/Top/Power State/SENSE_I_CH1: R601.1, TP110.1 (1_1), U102.5 (VOUT)
/Top/Power State/SENSE_I_CH2: R602.1, TP111.1 (1_1), U104.5 (VOUT)
/Top/Power State/SENSE_I_IN: R103.2, R604.1, TP112.1 (1_1)
/Top/Power State/SENSE_R_VOUT: NT105.2, R116.1
/Top/Power State/SENSE_VIN: R118.2, R119.1, U602.3 (+)
/Top/Power State/SENSE_VOUT: R116.2, R117.1, U601.3 (+)
/Top/Power State/SENSE_VREF1: TP108.1 (1_1), U102.4 (VREF)
/Top/Power State/SENSE_VREF2: TP109.1 (1_1), U104.4 (VREF)
/Top/Power Supplies/5V_SW: C314.2, L304.1, U302.6 (SW)
/Top/Power Supplies/5V_VIN: C310.1, L303.1, R302.2
/Top/Power Supplies/5V_VIN__FILT: C311.1, C312.1, C313.1, L303.2, R307.1, U302.5 (VIN)
/Top/Power Supplies/9V_SW: C305.2, L302.1, U301.6 (SW)
/Top/Power Supplies/9V_VIN: C301.1, L301.1, R301.2
/Top/Power Supplies/9V_VIN__FILT: C302.1, C303.1, C304.1, L301.2, R303.1, U301.5 (VIN)
/Top/Power Supplies/+5VUSB: C329.1, D301.1 (K), R313.1, U306.3 (~CE), U306.6 (VOUT)
/Top/Power Supplies/A3V3_IN: C326.1, NT305.1, R311.2, U305.1 (IN)
/Top/Power Supplies/BP_3V3: C320.1, U303.4 (BP)
/Top/Power Supplies/BP_3V3_S: C323.1, U304.4 (BP)
/Top/Power Supplies/BUS_LED_A: LD301.2 (A), R312.2
/Top/Power Supplies/CB_5V: C314.1, U302.1 (CB)
/Top/Power Supplies/CB_9V: C305.1, U301.1 (CB)
/Top/Power Supplies/EN_3V3: NT303.2, U303.3 (EN)
/Top/Power Supplies/EN_3V3_S: NT304.2, U304.3 (EN)
/Top/Power Supplies/EN_5V: R307.2, R308.1, U302.4 (EN)
/Top/Power Supplies/EN_9V: R303.2, R304.1, U301.4 (EN)
/Top/Power Supplies/EN_A3V3: NT305.2, U305.3 (EN)
/Top/Power Supplies/FB_5V: R309.2, R310.1, U302.3 (FB)
/Top/Power Supplies/FB_9V: R305.2, R306.1, U301.3 (FB)
/Top/User Interface/BT1_USER_NODE: B901.3, B901.4, D901.1, R901.2, R903.1
/Top/User Interface/BT_RESET: B902.1, B902.2, D902.1, R902.2
/Top/User Interface/SW1_P1: R904.2, SW901.1 (A)
/Top/User Interface/SW1_POUT: D903.1, R905.1, SW901.2 (B)
/Top/User LEDs/FLT_G: Q803.1 (G), R807.2
/Top/User LEDs/IDLE_G: Q801.1 (G), R805.2
/Top/User LEDs/LED_FLT_A: LD803.2 (A), R803.2
/Top/User LEDs/LED_FLT_K: LD803.1 (K), Q803.3 (D)
/Top/User LEDs/LED_IDLE_A: LD801.2 (A), R801.2
/Top/User LEDs/LED_IDLE_K: LD801.1 (K), Q801.3 (D)
/Top/User LEDs/LED_RUN_A: LD802.2 (A), R802.2
/Top/User LEDs/LED_RUN_K: LD802.1 (K), Q802.3 (D)
/Top/User LEDs/LED_USER1_A: LD804.2 (A), R804.2
/Top/User LEDs/LED_USER1_K: LD804.1 (K), Q804.3 (D)
/Top/User LEDs/RUN_G: Q802.1 (G), R806.2
/Top/User LEDs/USER1_G: Q804.1 (G), R808.2
GND: B902.3, B902.4, C101.2, C102.2, C103.2, C104.2, C105.2, C106.2, C107.2, C108.2, C110.2, C111.2, C112.2, C113.2, C114.2, C115.2, C116.2, C117.2, C118.2, C119.2, C120.2, C122.2, C123.2, C124.2, C125.2, C126.2, C127.2, C128.2, C129.2, C130.2, C131.2, C132.2, C133.2, C134.2, C135.2, C136.2, C137.2, C138.2, C139.2, C140.2, C141.2, C142.2, C143.2, C145.2, C301.2, C302.2, C303.2, C304.2, C306.2, C307.2, C308.2, C309.2, C310.2, C311.2, C312.2, C313.2, C315.2, C316.2, C317.2, C318.2, C319.2, C320.2, C321.2, C322.2, C323.2, C324.2, C325.2, C326.2, C327.2, C328.2, C329.2, C401.2, C402.2, C403.2, C404.2, C405.2, C406.2, C407.2, C408.2, C409.2, C501.2, C502.2, C601.2, C602.2, C603.2, C604.2, C605.2, C606.2, C607.1, C701.2, C702.2, C703.2, C704.2, C705.2, C706.2, C801.2, C802.2, C901.2, C902.2, C903.2, CN201.1, CN201.2, CN202.1, CN202.2, CN203.1, CN203.2, CN204.1, CN204.2, CN205.2 (Ext), CN701.A1 (GND), CN701.A12 (GND), CN701.B1 (GND), CN701.B12 (GND), CN701.SH (SHIELD), CN702.3 (GND), CN702.5 (GND), CN702.9 (GND), CN703.2, CN703.4, CN703.6, CN703.8, CN703.10, CN703.12, CN703.14, CN703.16, CN703.MP (MountPin), CN704.2, CN704.4, CN704.MP (MountPin), D201.2, D202.2, D701.2, D702.3 (A), D702.8 (A), D703.3 (A), D703.8 (A), D704.3 (A), D704.8 (A), D705.2, D706.2, D901.2, D902.2, D903.2, LD301.1 (K), Q102.1, Q104.1, Q801.2 (S), Q802.2 (S), Q803.2 (S), Q804.2 (S), R106.2, R112.2, R117.2, R119.2, R201.2, R304.2, R306.2, R308.2, R310.2, R502.2, R702.2, R703.2, R718.2, R719.2, R720.2, R721.2, R809.2, R810.2, R811.2, R812.2, R901.1, R904.1, TP113.1 (1_1), TP114.1 (1_1), TP307.1 (1_1), TP603.1 (1_1), TP604.1 (1_1), U101.9 (VSS), U101.11 (VSS), U102.3 (GND), U103.9 (VSS), U103.11 (VSS), U104.3 (GND), U106.2 (GND), U106.5 (REF), U301.2 (GND), U302.2 (GND), U303.2 (GND), U304.2 (GND), U305.2 (GND), U306.2 (GND), U401.15 (VSS), U401.27 (VSSA), U401.31 (VSS), U401.47 (VSS), U401.63 (VSS), U402.2 (GND), U402.3 (GND), U402.5 (GND), U601.2 (V-), U602.2 (V-), U701.2 (GND), X501.2 (G), X501.4 (G)
unnamed: C115.1, R109.2
unnamed: C127.1, R115.2
unnamed: D702.2 (K), D702.9
PWR_VIN_FILT: C104.1, C105.1, C110.1, C111.1, C112.1, C113.1, C114.1, C122.1, C123.1, C124.1, C125.1, C126.1, L101.2, Q101.8, Q103.8, TP105.1 (1_1)
