Natchpai/LQRx-InterleavedBuck/(commit log)

2026-10-17 chore(board): update KiCad board and project data
    [2Phase_SynchBuck.kicad_pcb]
2026-10-17 chore(project): organize project docs and outputs
    [BOM_2Phase_SynchBuck_v1.1_2026-09-01.csv]
2026-10-17 docs(readme): update schematic tree and timing
2026-10-17 chore(repo): clean generated KiCad artifacts
